LucasCalcada/projeto-microcontroladores-2/models/MainBody.STL

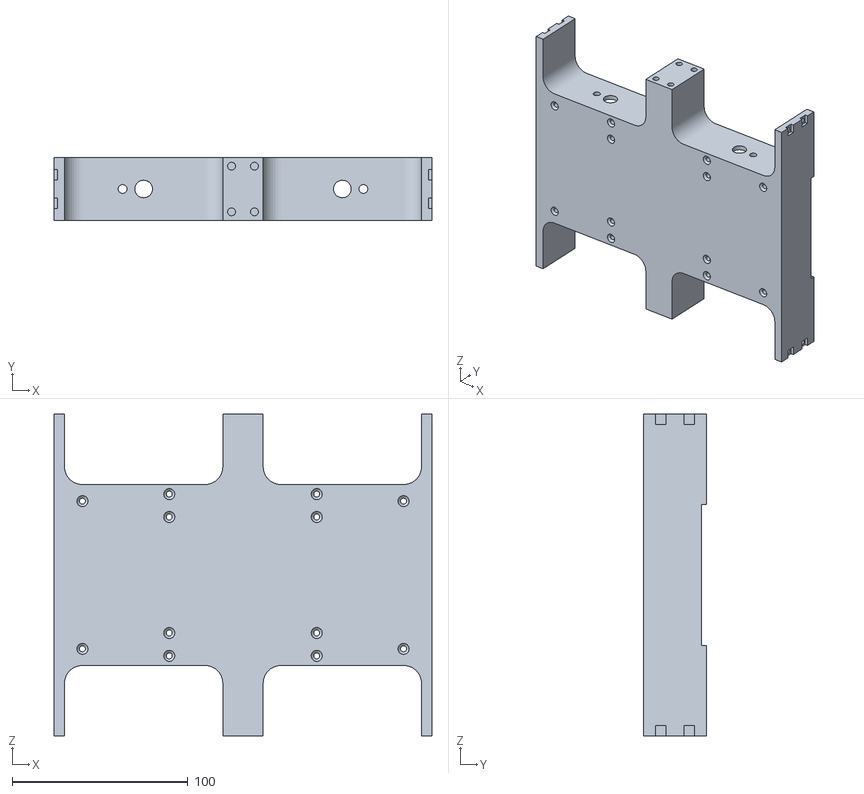
[picture p2: CAD file, 2026-11-09]
models/MainBody.STL
215.0 x 36.0 x 183.0
