LucasCalcada/projeto-microcontroladores-2/models/Camera/Cover.STL

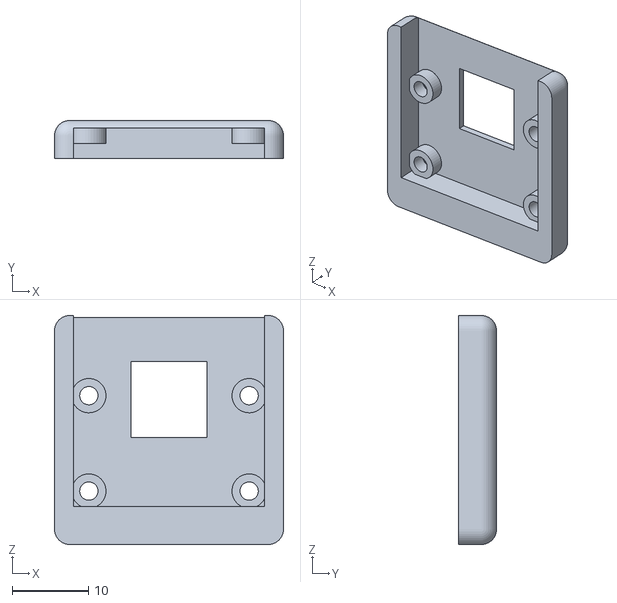
[picture p3: CAD file, 2026-11-09]
models/Camera/Cover.STL
30.0 x 5.00 x 30.0
