LucasCalcada/projeto-microcontroladores-2/models/LateralBracket.STL

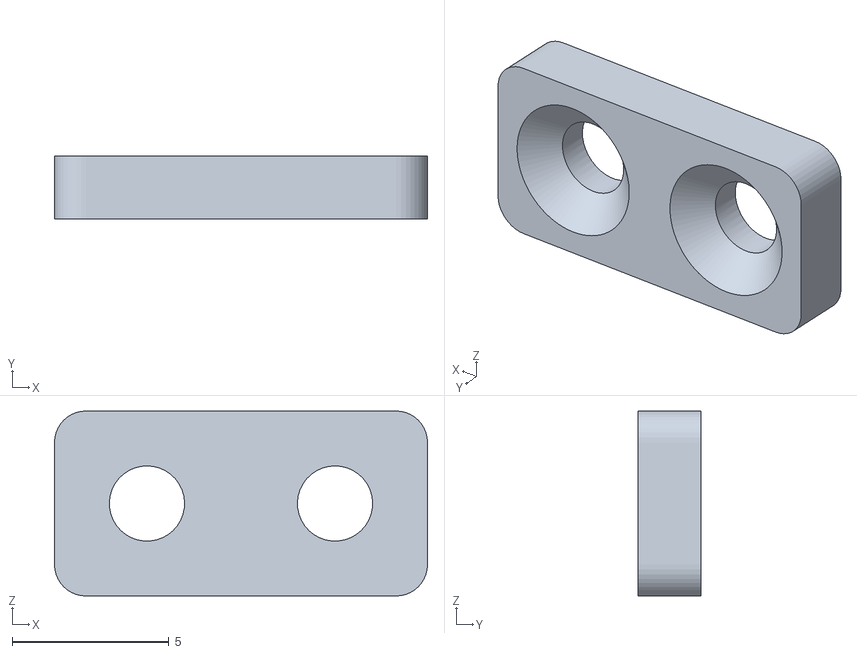
[picture p4: CAD file, 2026-11-09]
models/LateralBracket.STL
11.9 x 2.00 x 5.90
