LucasCalcada/projeto-microcontroladores-2/models/Camera/Bracket.STL

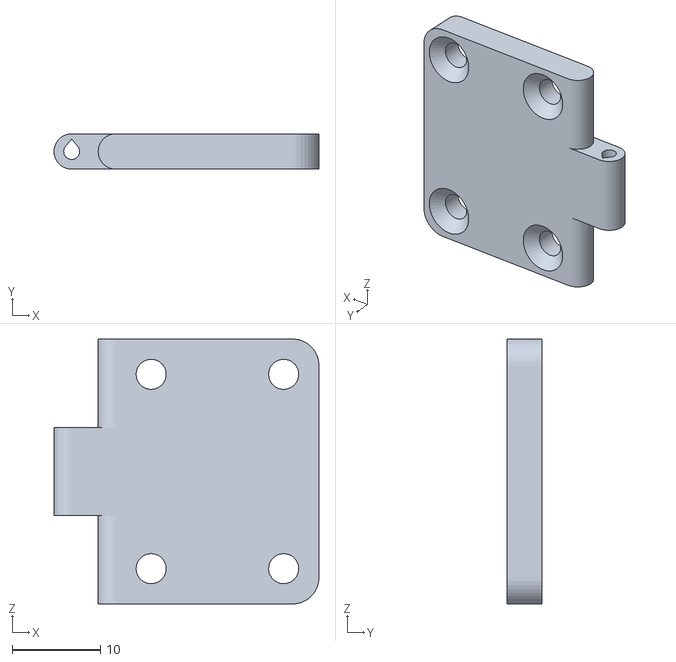
[picture p5: CAD file, 2026-11-09]
models/Camera/Bracket.STL
30.0 x 4.00 x 30.0
