LucasCalcada/projeto-microcontroladores-2/models/RaspSupport.STL

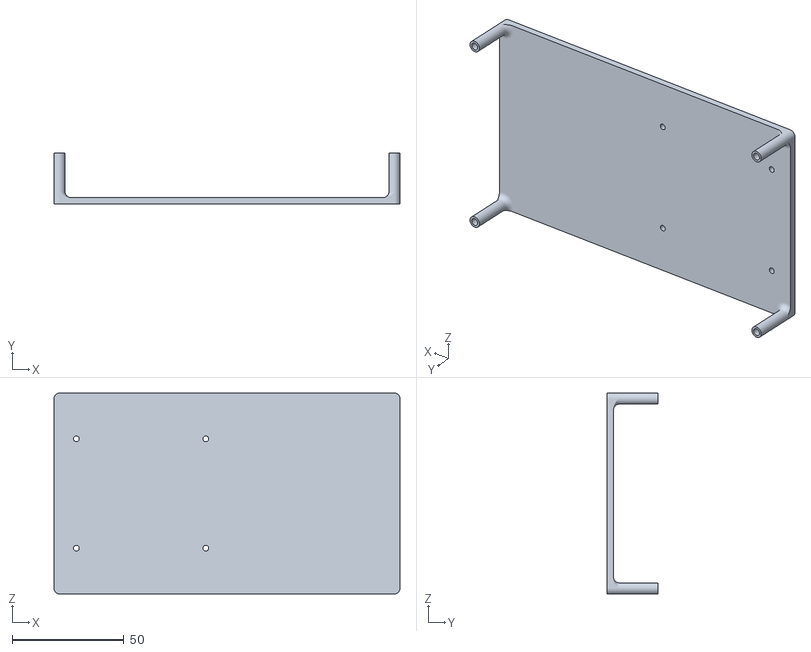
[picture p6: CAD file, 2026-11-09]
models/RaspSupport.STL
155.0 x 23.0 x 90.0
