LucasCalcada/projeto-microcontroladores-2/models/MotorBracket.STL

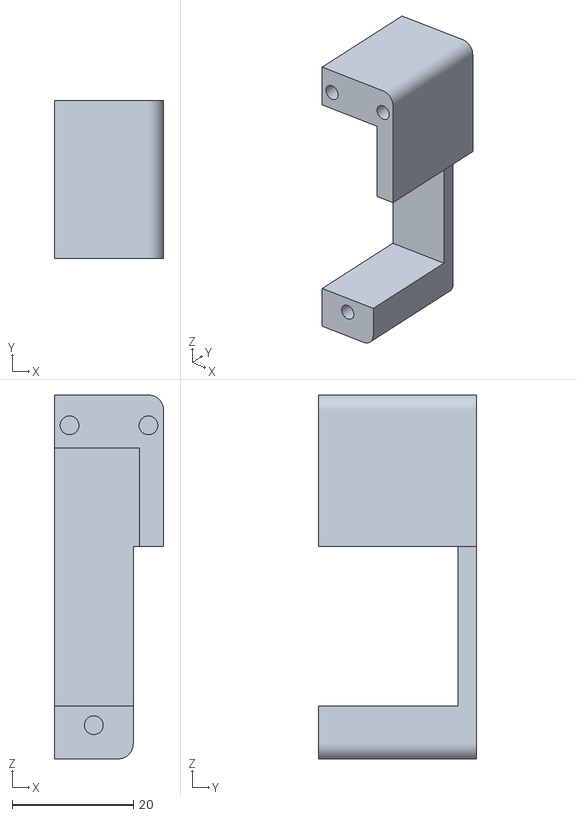
[picture p7: CAD file, 2026-11-09]
models/MotorBracket.STL
18.0 x 26.0 x 60.0
