LucasCalcada/projeto-microcontroladores-2/models/WheelSpacer.STL

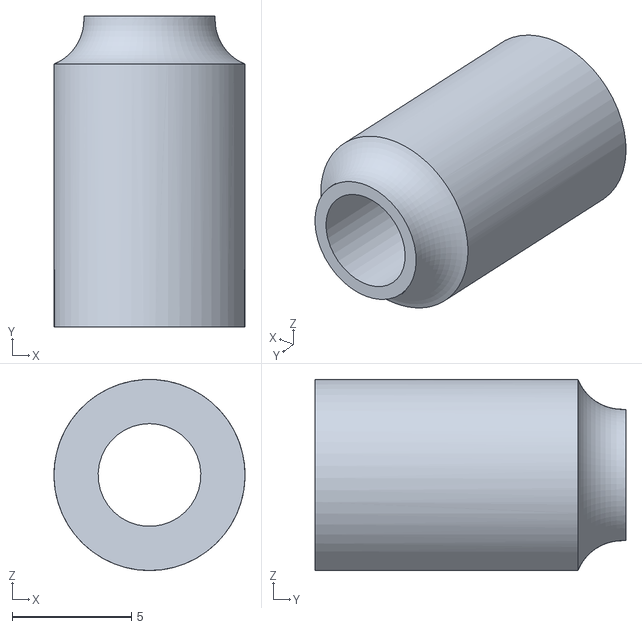
[picture p8: CAD file, 2026-11-09]
models/WheelSpacer.STL
8.00 x 13.0 x 8.00
