LucasCalcada/projeto-microcontroladores-2/models/Lateral.STL

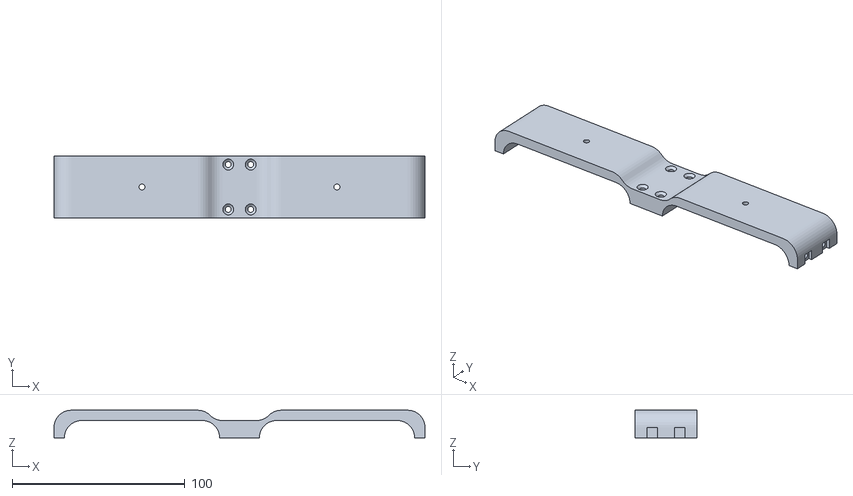
[picture p9: CAD file, 2026-11-09]
models/Lateral.STL
215.0 x 36.0 x 16.0
