LucasCalcada/projeto-microcontroladores-2/models/BodyLid.STL

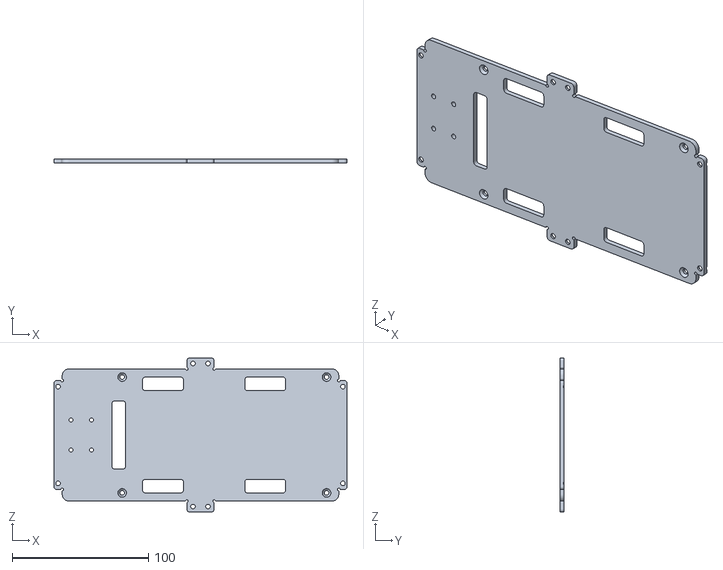
[picture p10: CAD file, 2026-11-09]
models/BodyLid.STL
215.0 x 3.00 x 113.0
