LucasCalcada/projeto-microcontroladores-2/models/MotorAxle.STL

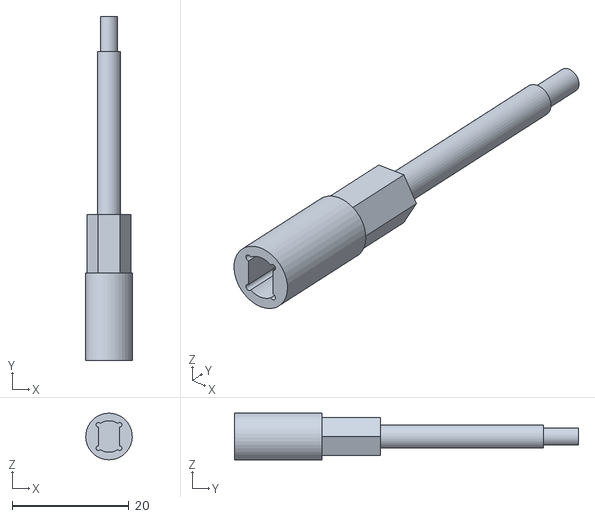
[picture p11: CAD file, 2026-11-09]
models/MotorAxle.STL
7.99 x 59.0 x 8.00
