LucasCalcada/projeto-microcontroladores-2/driver/board/Quad Motor Driver Module.pdf

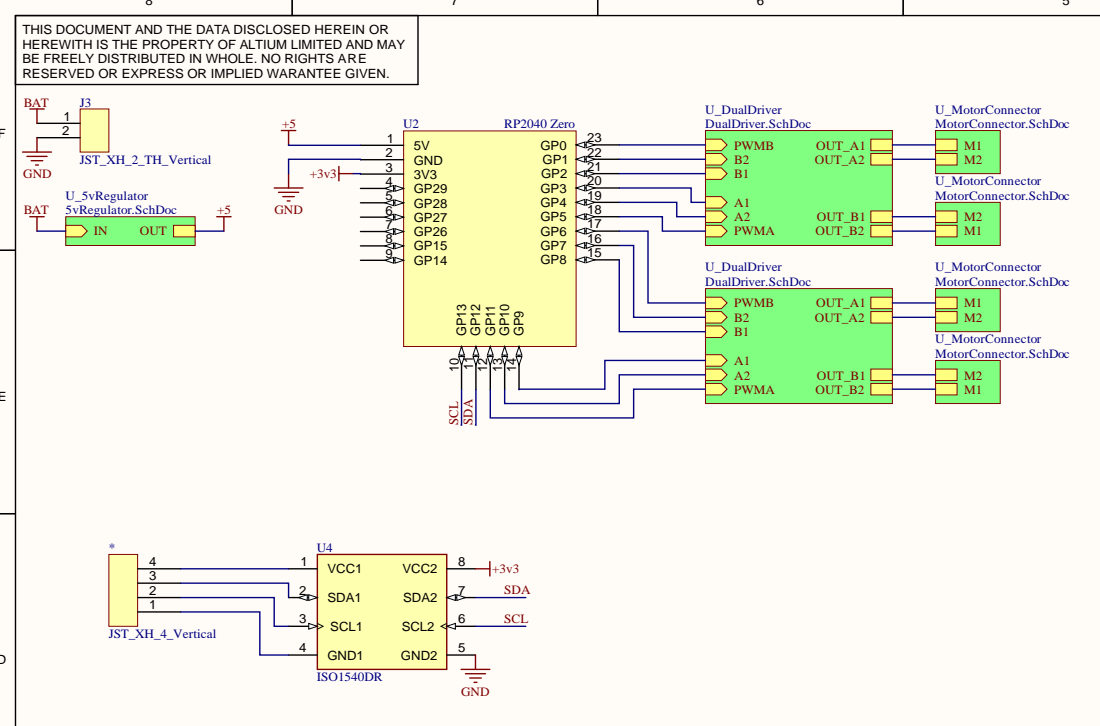
[picture p12: page 1]

<SCH DWG NO> | DWG. NO. | REV. | 1 SHT.

THIS DOCUMENT AND THE DATA DISCLOSED HEREIN OR HEREWITH IS THE PROPERTY OF ALTIUM LIMITED AND MAY BE FREELY DISTRIBUTED IN WHOLE. NO RIGHTS ARE RESERVED OR EXPRESS OR IMPLIED WARANTEE GIVEN. | | REVISION | DESCRIPTION | DATE | APPROVED

U4 | GP29 4 | U_MotorConnector MotorConnector.SchDoc

REV. SHT. DWG. NO.

DATE | PROJECT * | * * APPROVALS * *

ENG: * | --/--/--

DSN: * | --/--/--

PROJECTREVISION: | DOCUMENTREVISION: | DESIGN ITEM:

CHK: * | --/--/--

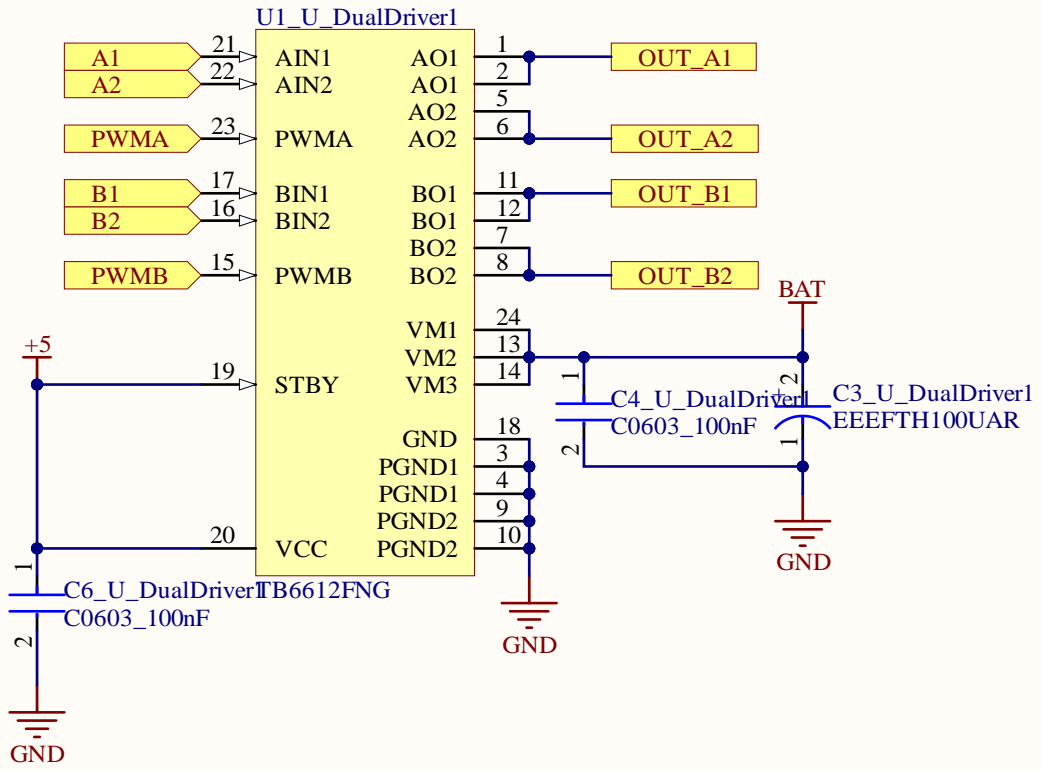
[picture p13: page 2]

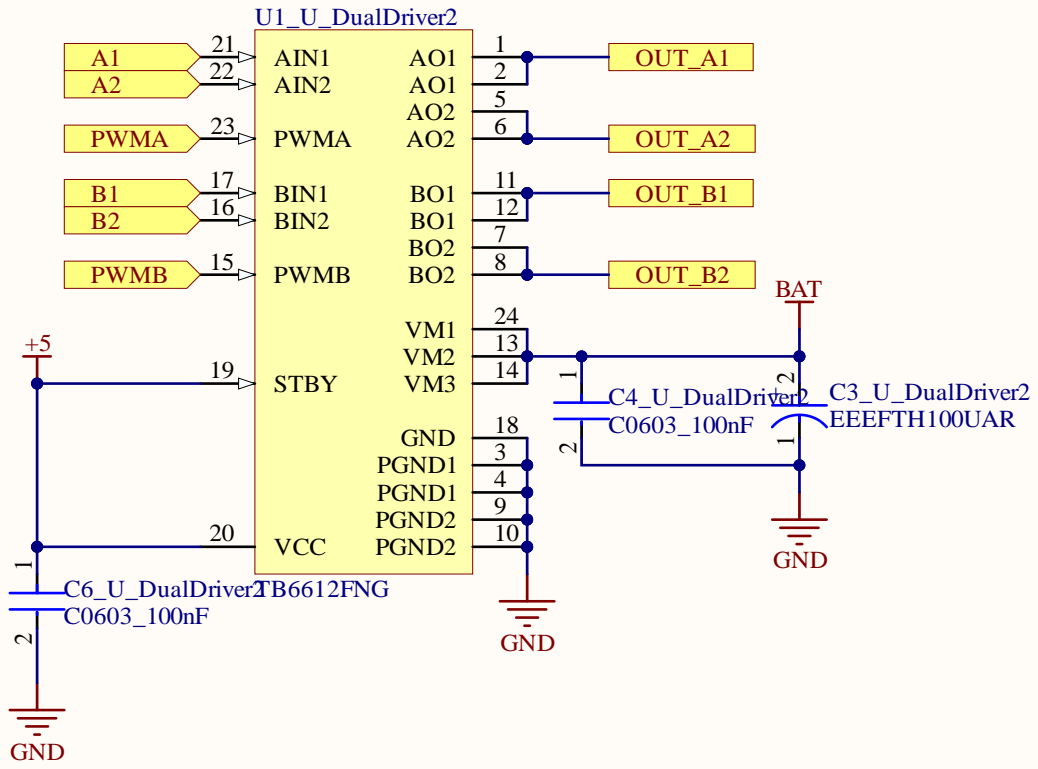
[picture p14: page 3]

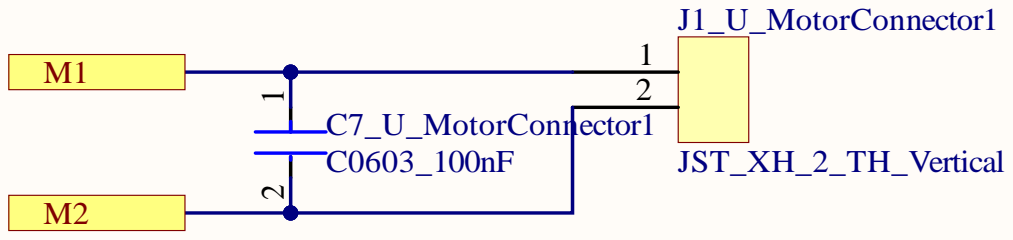
[picture p15: page 4]

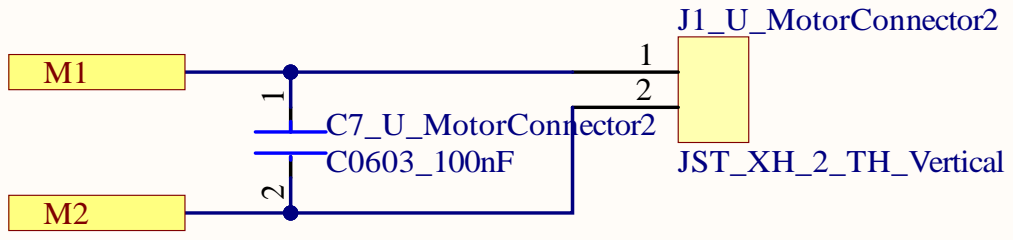
[picture p16: page 5]

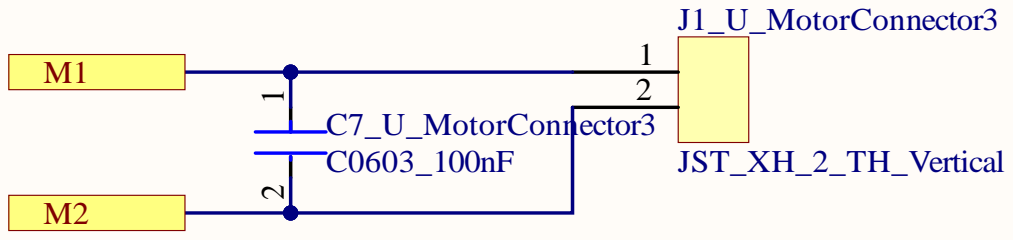
[picture p17: page 6]

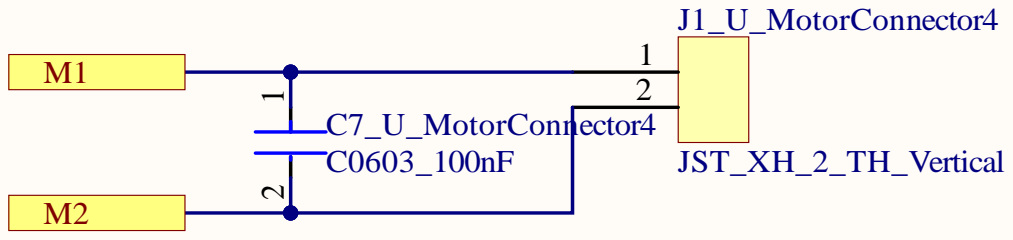
[picture p18: page 7]

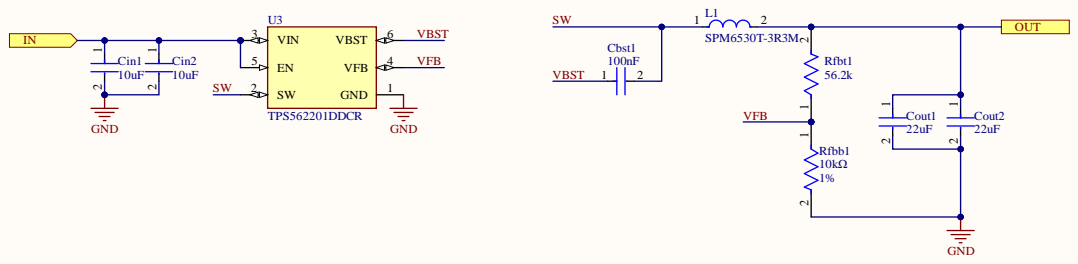
[picture p19: page 8]
