LucasCalcada/projeto-microcontroladores-2/driver/firmware/include/omni_movement.h

#pragma once

#include <motor_driver.h>

typedef struct {
  Motor frontLeft;
  Motor frontRight;
  Motor backLeft;
  Motor backRight;
} OmnidirConfig;

typedef struct {
  float x;
  float y;
} Vector2;

typedef struct {
  Vector2 translation;
  float rotation;
} OmnidirMovement;

void omni_move(OmnidirMovement movement);
