LucasCalcada/projeto-microcontroladores-2/driver/firmware/include/i2c_interface.h

#pragma once

#include <hardware/i2c.h>
#include <omni_movement.h>

typedef struct {
  i2c_inst_t *i2c;
  uint sda;
  uint scl;
  int baudrate;
} I2C_Config;

typedef struct {
  OmnidirMovement movement;
} I2C_Packet;

void interface_init();

bool command_ready();
OmnidirMovement get_movement();
