LucasCalcada/projeto-microcontroladores-2/(commit log)

2026-11-06 feat: add motor driver logic
2026-11-06 chore: refactor motor logic
2026-11-06 feat: move pin configuration into robot.h
2026-11-06 feat: add i2c interface
2026-11-06 fix: motor order
2026-11-07 feat: add webserver prototype
2026-11-07 fix: camera import
2026-11-07 feat: add motor control websocket
2026-11-08 fix: csi camera recording
    [csi_camera.py]
2026-11-08 fix: camera flip
2026-11-08 feat: update motor drive logic
2026-11-08 fix: pwm logic
2026-11-08 fix(webserver): fix camera orientation
    [csi_camera.py]
2026-11-09 chore: remove battery indicator from dashboard
2026-11-09 feat: add driver schematic
2026-11-09 feat: add 3d models
    [BodyLid.STL, Bracket.STL, Cover.STL, Lateral.STL, LateralBracket.STL, MainBody.STL, MotorAxle.STL, MotorBracket.STL]
